UCSD-LabStream/Electrical-Mechanical/AUTO CAD/ESS.pdf

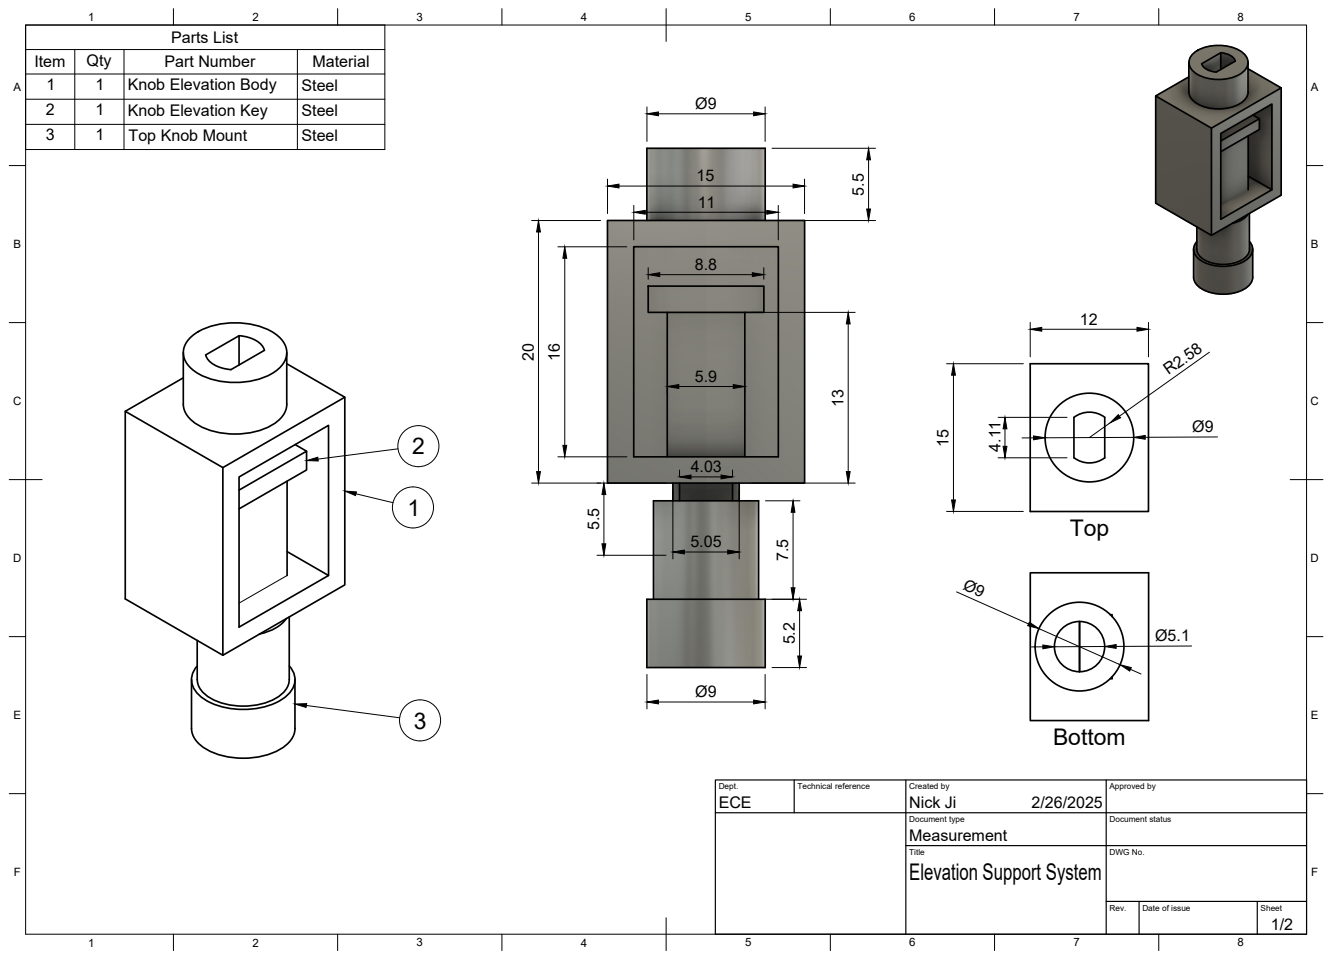
[picture p11: page 1]
Parts List

Item | Qty | Part Number | Material
1 | 1 | Knob Elevation Body | Steel
2 | 1 | Knob Elevation Key | Steel
3 | 1 | Top Knob Mount | Steel

Dept. ECE | Technical reference | Created by Nick Ji 2/26/2025 | Approved by

Document type Measurement | Document status

Title Elevation Support System | DWG No.

Rev. | Date of issue | Sheet 1/2

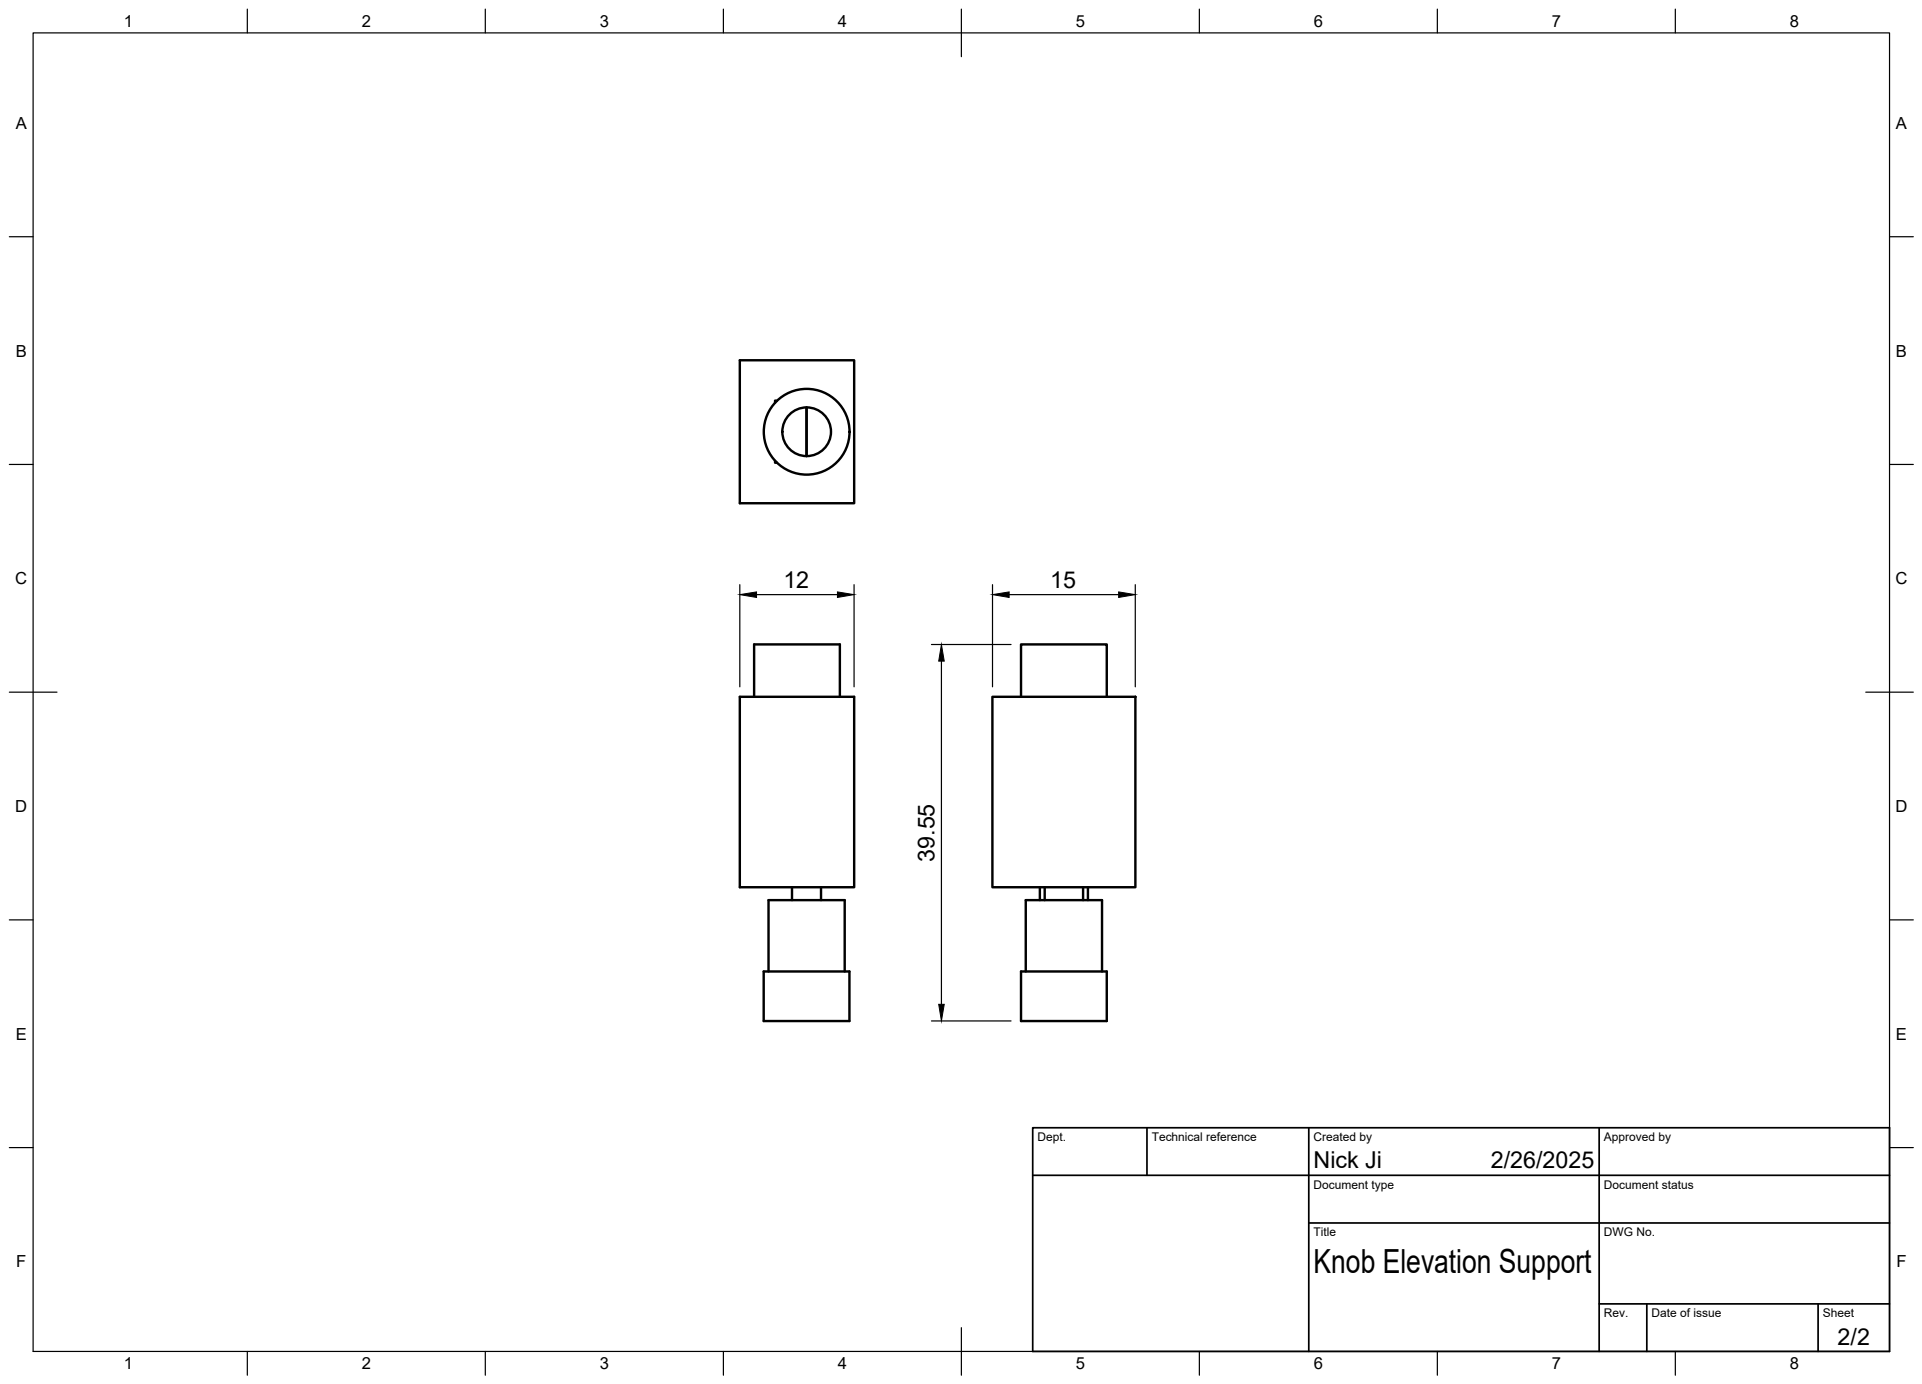
[picture p12: page 2]
Title; DWG No.; Rev.; Date of issue; Sheet

Dept. | Technical reference | Created by Nick Ji 2/26/2025 | Approved by

Document type | Document status

Knob Elevation Support
