UCSD-LabStream/Electrical-Mechanical/AUTO CAD/GDSM.pdf

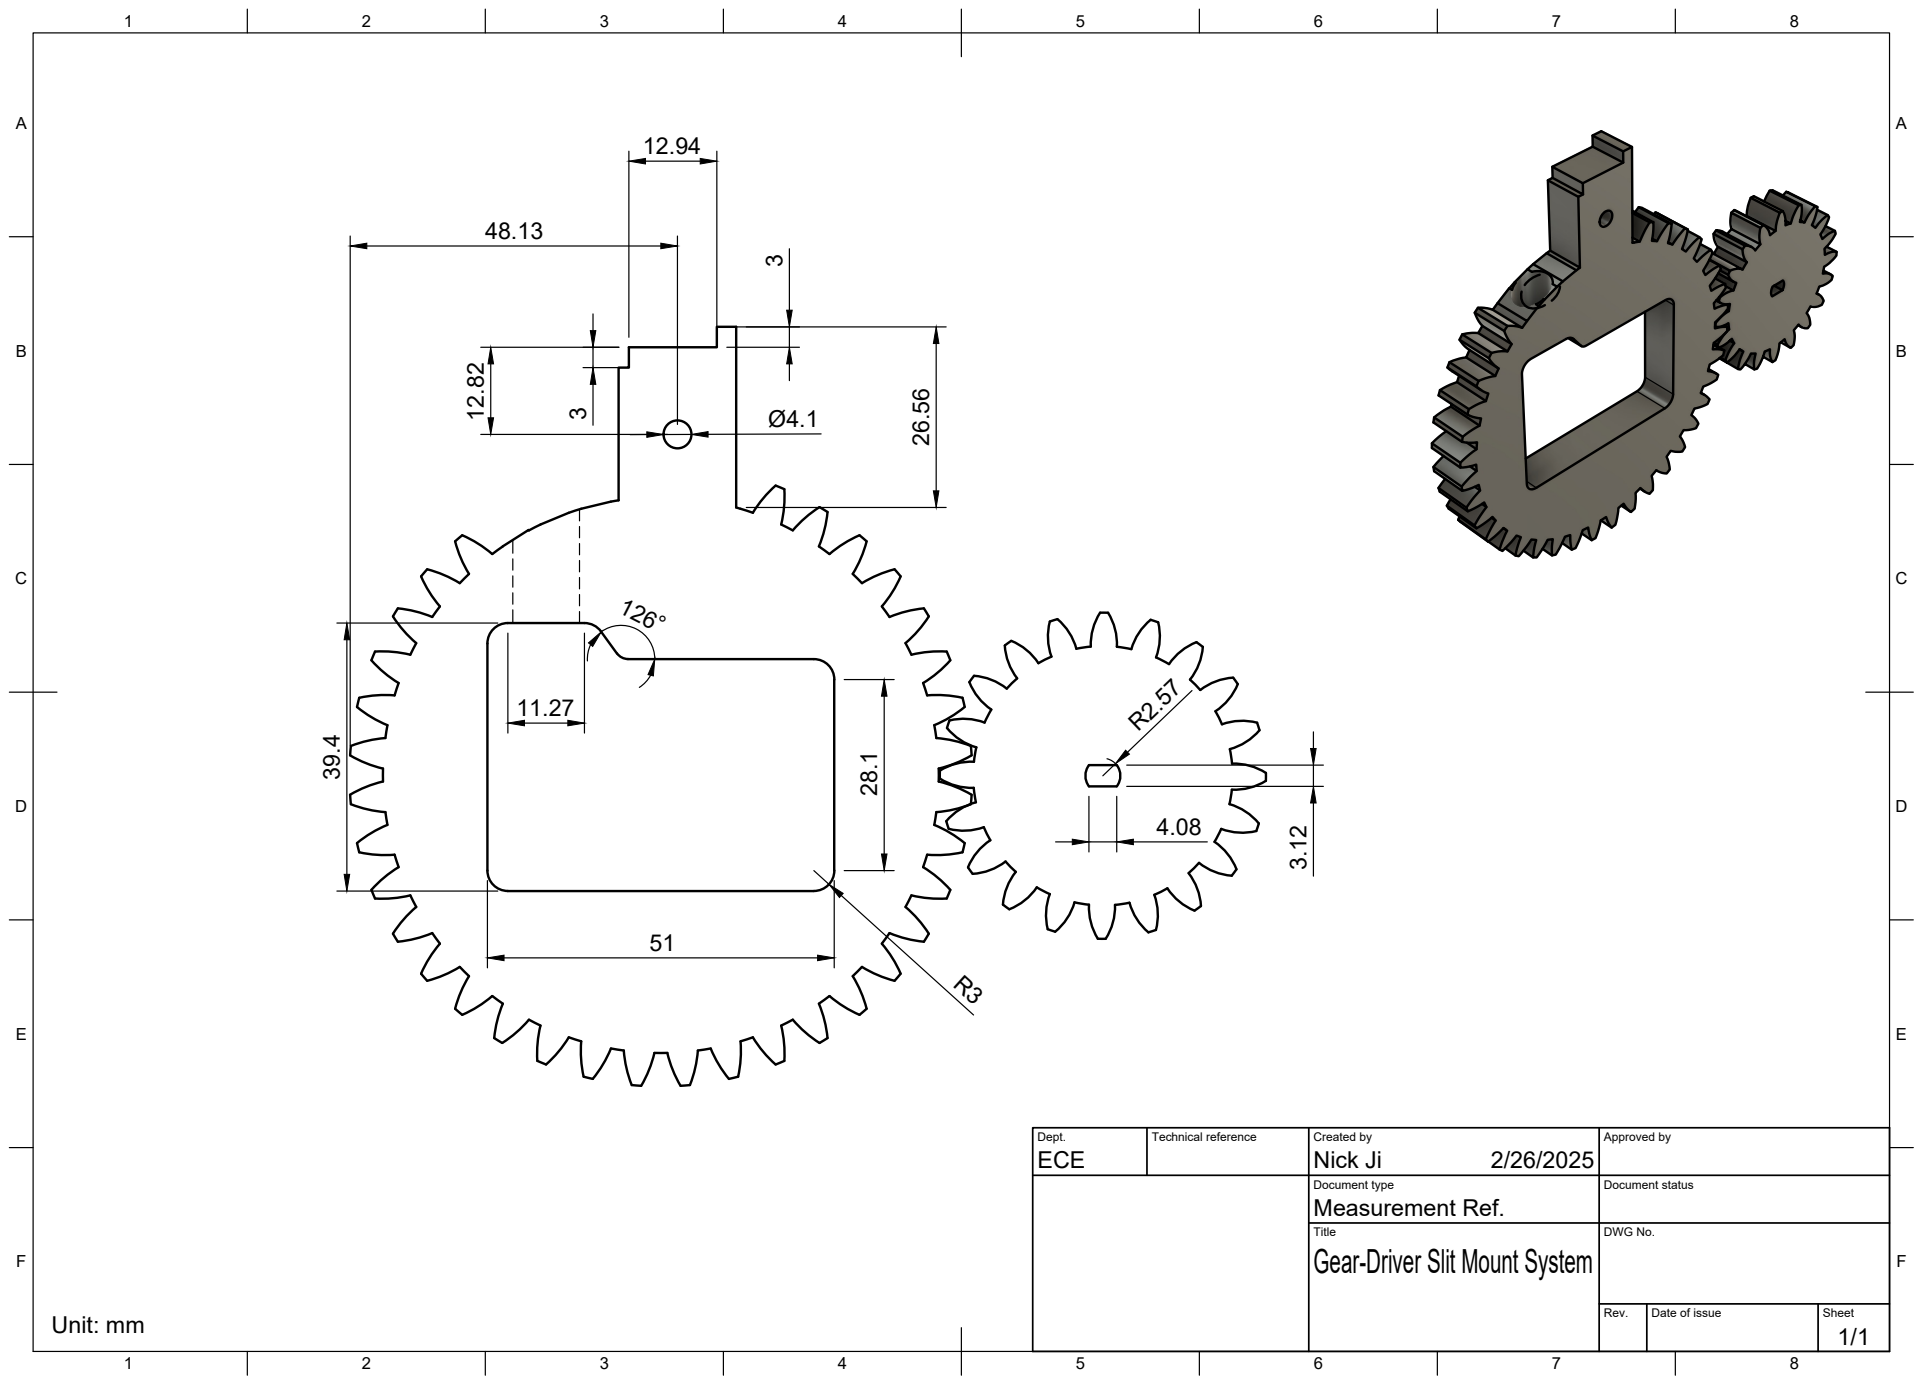
[picture p13: page 1]
Title; DWG No.; Rev.; Date of issue; Sheet; Unit: mm

Dept. ECE | Technical reference | Created by Nick Ji 2/26/2025 | Approved by

Document type Measurement Ref. | Document status

Gear-Driver Slit Mount System
