UCSD-LabStream/Electrical-Mechanical/(commit log)

2025-02-25 Create User_Controlled_Stepper.ino
    .ino file for controlling stepper motor using key input
2025-02-25 Create User_Controlled_Stepper.py
    Python file for user controlled stepper motors
2025-02-25 Rename VA100.pdf to AUTO CAD/VA100.pdf
2025-04-28 connecting broker to raw TCP 1883 on esp, edited test codes
    [main.cpp]
2025-05-05 switched to raw tcp
